krishsingh2008/haptic-teleop-arm/docs/images/glove-v2-concept.png

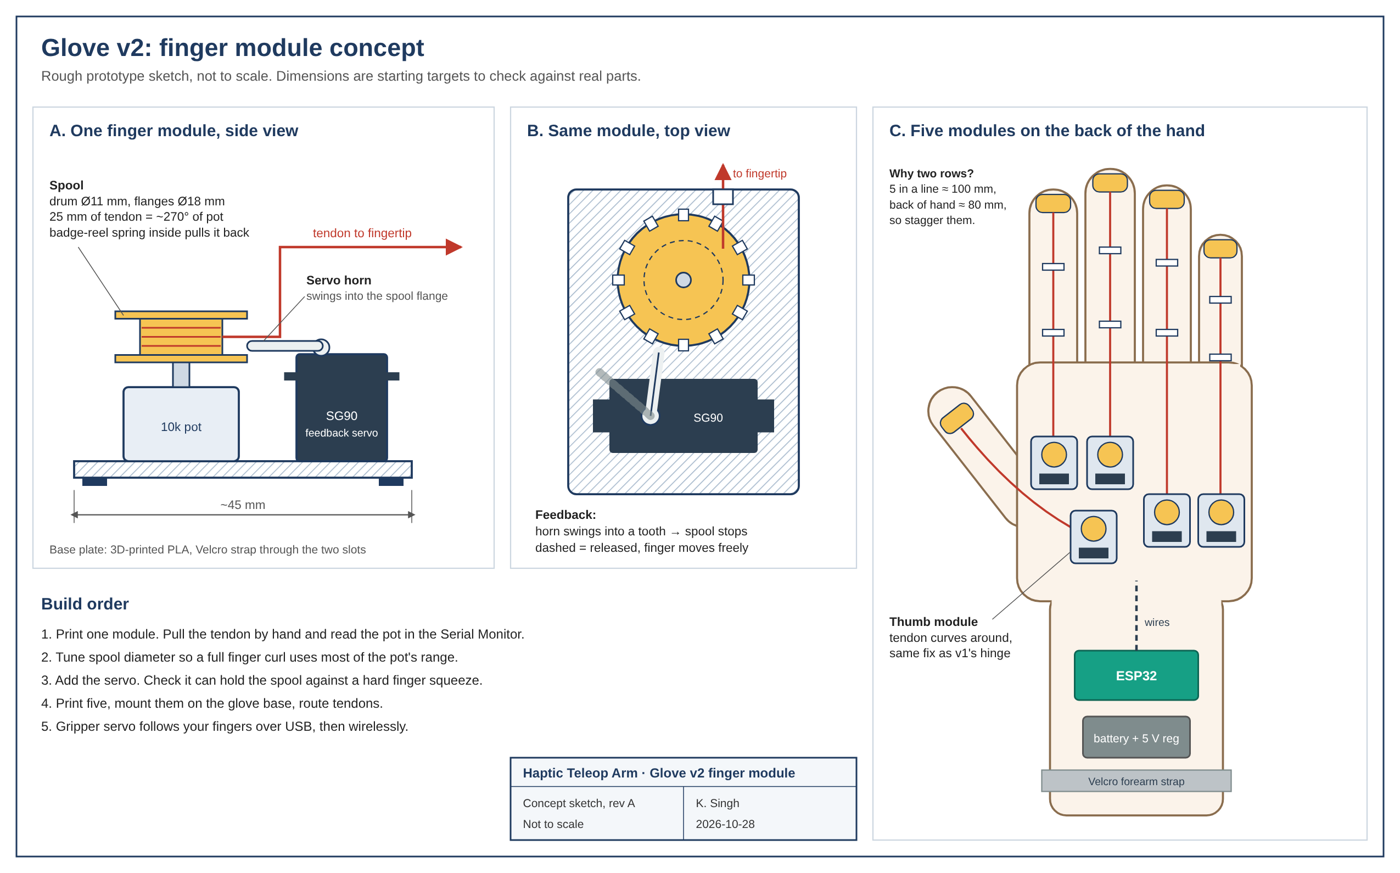
docs/images/glove-v2-concept.png
