krishsingh2008/haptic-teleop-arm/cad/hand_assembly.step

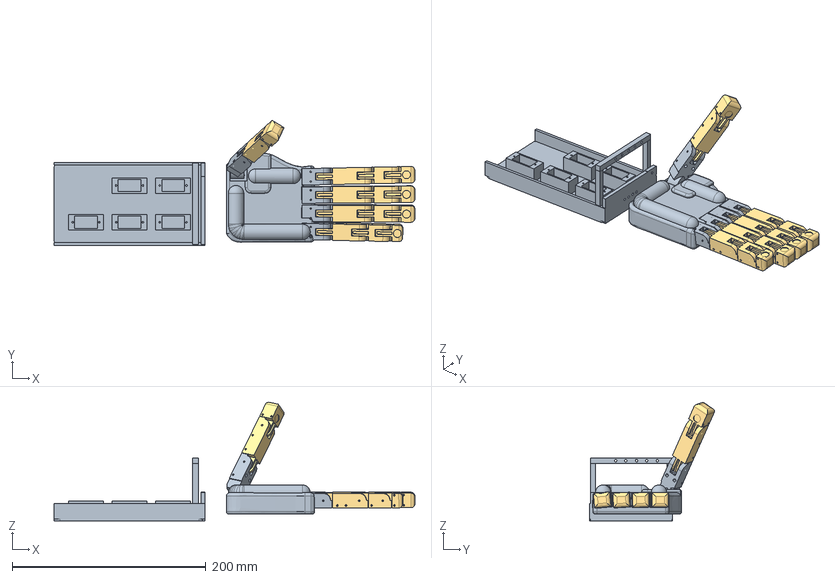
[picture p5: CAD file, 2026-11-10]
cad/hand_assembly.step
372.8 x 129.2 x 122.4 mm
palm
base_0
finger_proximal_0
finger_middle_0
finger_distal_0
base_1
finger_proximal_1
finger_middle_1
finger_distal_1
base_2
finger_proximal_2
finger_middle_2
finger_distal_2
base_3
little_proximal_3
little_middle_3
little_distal_3
thumb_carrier
thumb_proximal
thumb_distal
forearm_tray
s6_cover
tendon_comb
