krishsingh2008/haptic-teleop-arm/cad/parts/tendon_comb.step

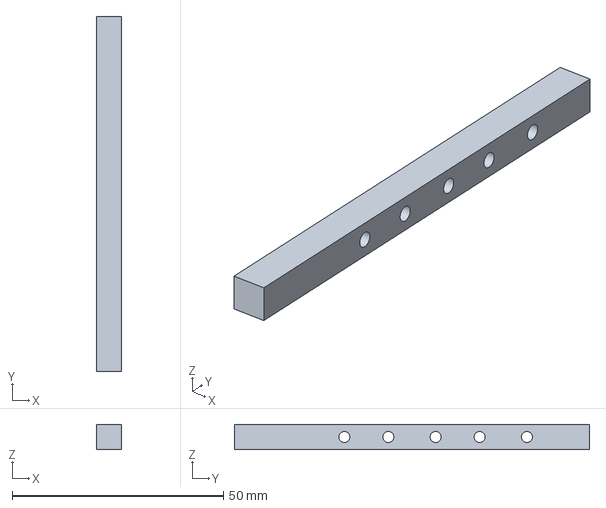
[picture p6: CAD file, 2026-11-10]
cad/parts/tendon_comb.step
6.00 x 84.0 x 6.00 mm
