krishsingh2008/haptic-teleop-arm/cad/parts_revC/finger_proximal.step

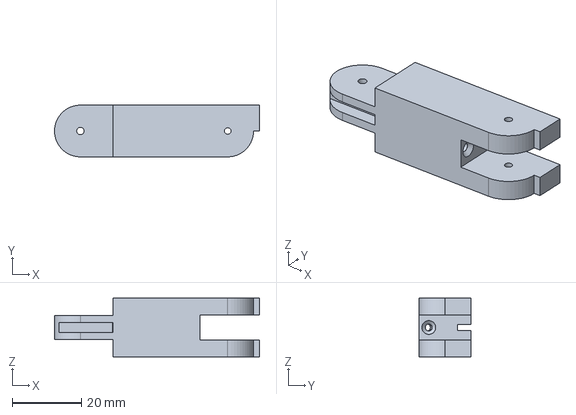
[picture p7: CAD file, 2026-11-10]
cad/parts_revC/finger_proximal.step
59.4 x 15.0 x 17.0 mm
