krishsingh2008/haptic-teleop-arm/cad/parts_revC/finger_middle.step

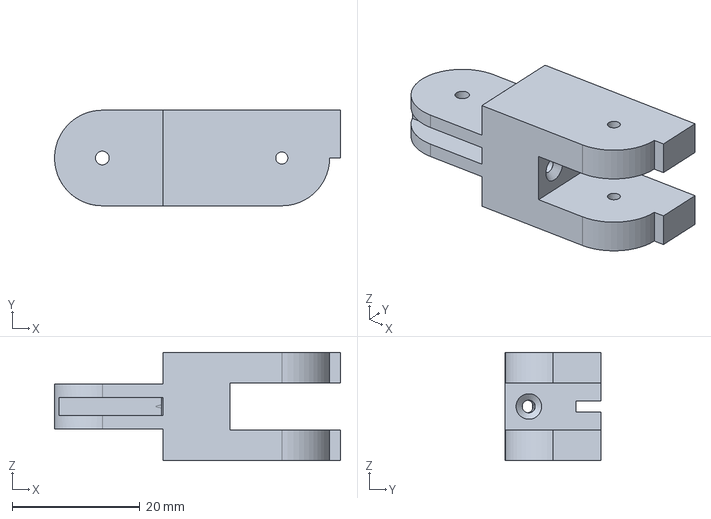
[picture p8: CAD file, 2026-11-10]
cad/parts_revC/finger_middle.step
44.8 x 15.0 x 17.0 mm
