krishsingh2008/haptic-teleop-arm/cad/parts/little_distal.step

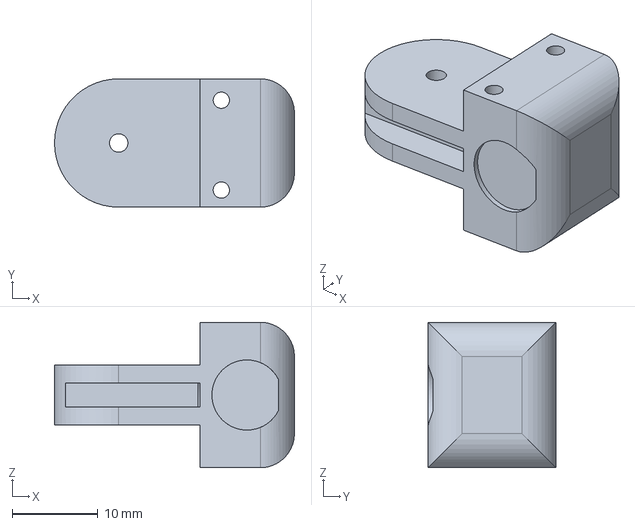
[picture p9: CAD file, 2026-11-10]
cad/parts/little_distal.step
28.1 x 15.0 x 17.0 mm
