krishsingh2008/haptic-teleop-arm/cad/parts/spool_20.step

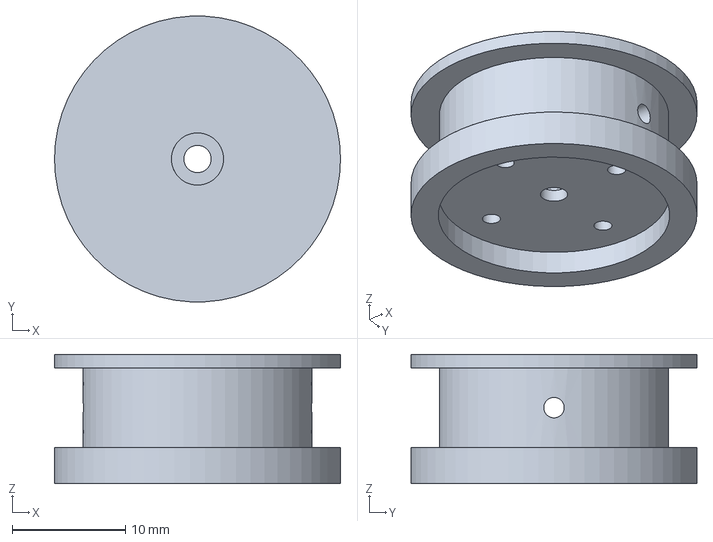
[picture p11: CAD file, 2026-11-10]
cad/parts/spool_20.step
25.2 x 25.2 x 11.4 mm
