krishsingh2008/haptic-teleop-arm/cad/parts_revC/finger_distal.step

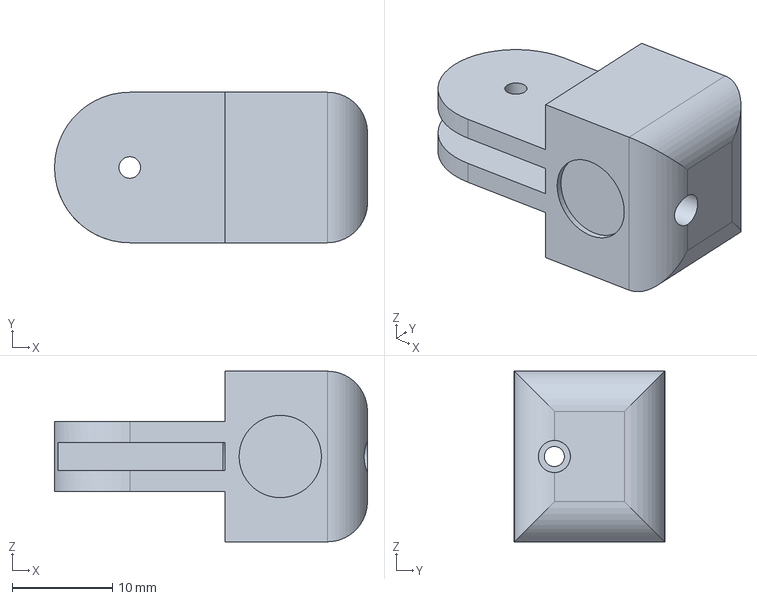
[picture p12: CAD file, 2026-11-10]
cad/parts_revC/finger_distal.step
31.2 x 15.0 x 17.0 mm
