krishsingh2008/haptic-teleop-arm/cad/parts/little_middle.step

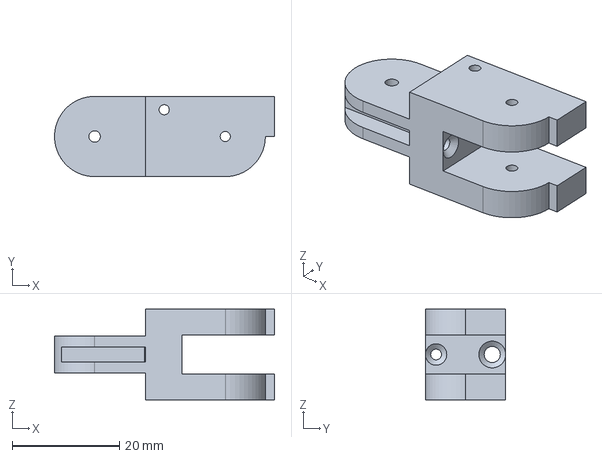
[picture p13: CAD file, 2026-11-10]
cad/parts/little_middle.step
41.1 x 15.0 x 17.0 mm
