krishsingh2008/haptic-teleop-arm/cad/parts/little_proximal.step

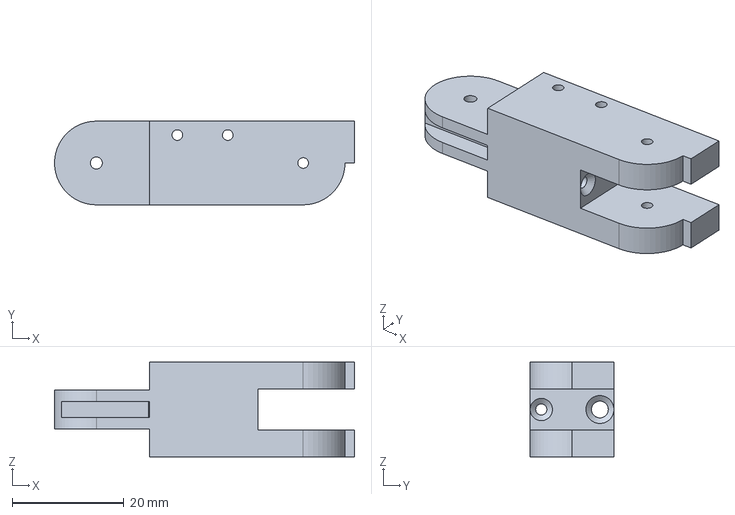
[picture p14: CAD file, 2026-11-10]
cad/parts/little_proximal.step
53.7 x 15.0 x 17.0 mm
