krishsingh2008/haptic-teleop-arm/cad/parts/s6_cover.step

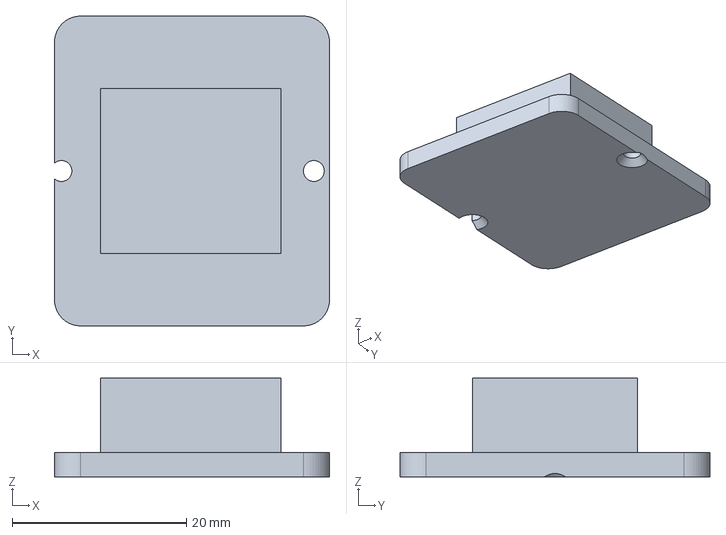
[picture p15: CAD file, 2026-11-10]
cad/parts/s6_cover.step
31.6 x 35.6 x 11.4 mm
