krishsingh2008/haptic-teleop-arm/cad/parts/forearm_tray.step

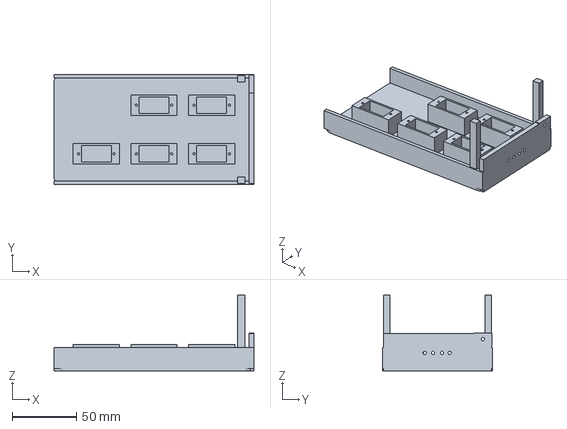
[picture p16: CAD file, 2026-11-10]
cad/parts/forearm_tray.step
156.0 x 86.0 x 59.0 mm
