krishsingh2008/haptic-teleop-arm/cad/parts/thumb_carrier.step

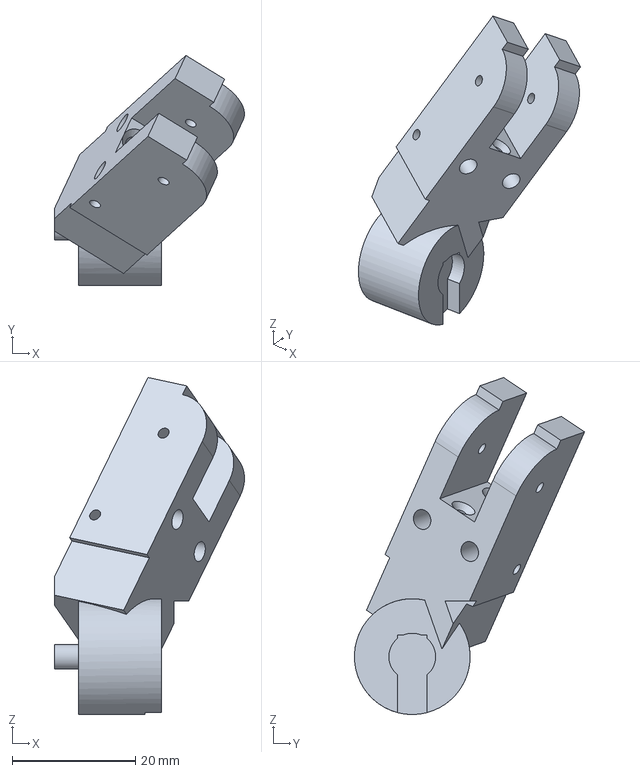
[picture p17: CAD file, 2026-11-10]
cad/parts/thumb_carrier.step
30.9 x 37.4 x 54.7 mm
