krishsingh2008/haptic-teleop-arm/cad/parts/palm.step

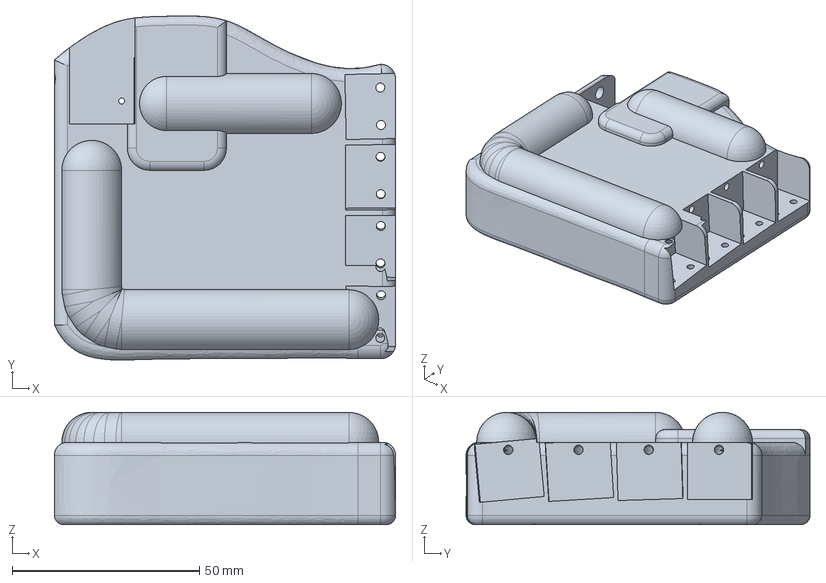
[picture p18: CAD file, 2026-11-10]
cad/parts/palm.step
91.2 x 92.0 x 30.0 mm
