krishsingh2008/haptic-teleop-arm/cad/parts/spool_32.step

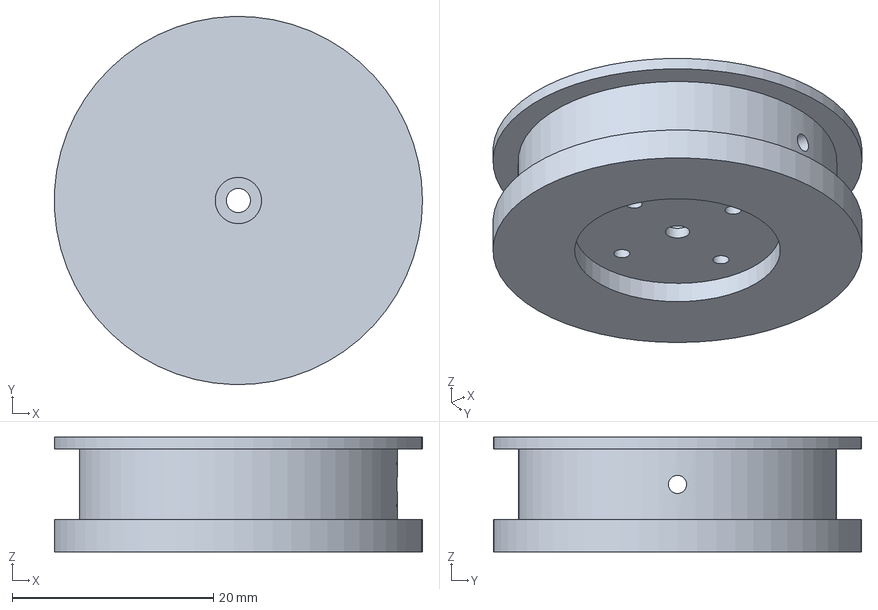
[picture p20: CAD file, 2026-11-10]
cad/parts/spool_32.step
36.6 x 36.6 x 11.4 mm
