krishsingh2008/haptic-teleop-arm/cad/parts/finger_test_rig.step

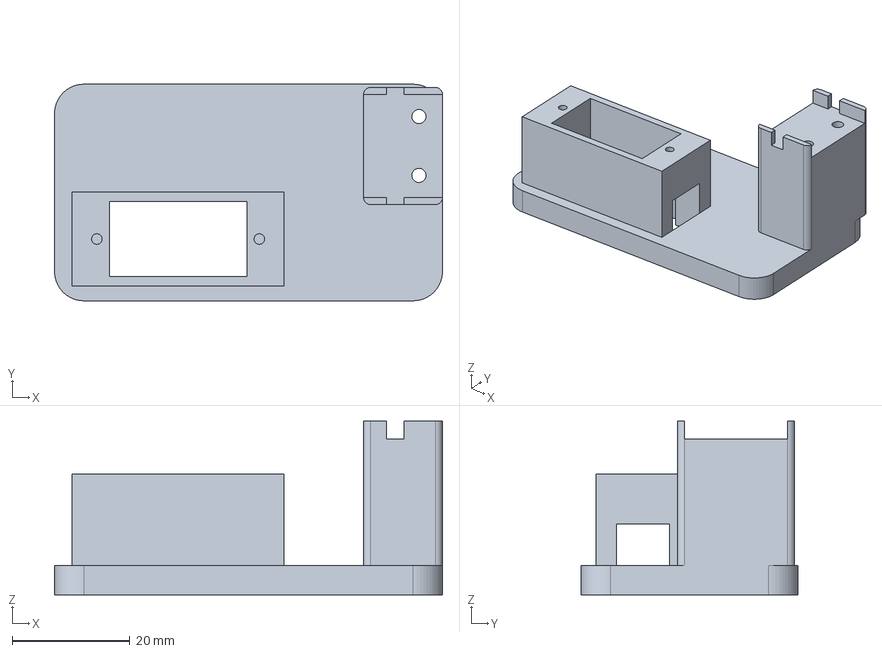
[picture p21: CAD file, 2026-11-10]
cad/parts/finger_test_rig.step
65.9 x 36.8 x 29.5 mm
