krishsingh2008/haptic-teleop-arm/cad/parts/thumb_proximal.step

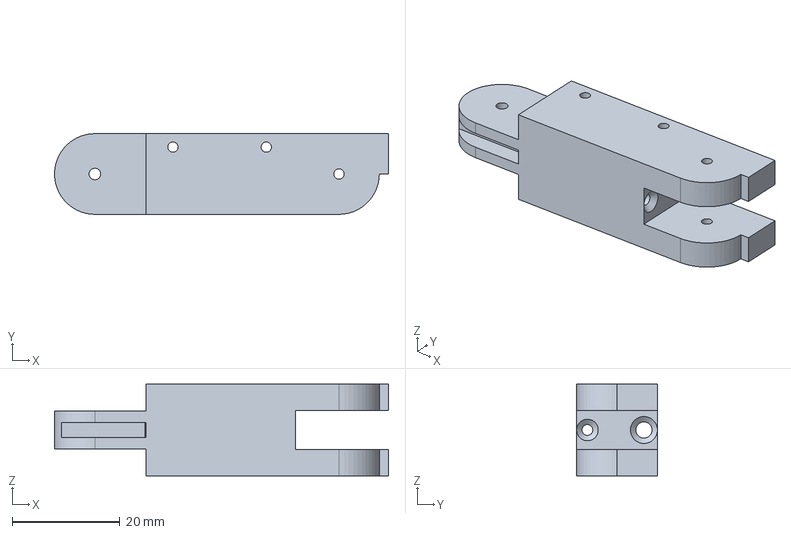
[picture p22: CAD file, 2026-11-10]
cad/parts/thumb_proximal.step
62.0 x 15.0 x 17.0 mm
