krishsingh2008/haptic-teleop-arm/cad/parts/finger_base.step

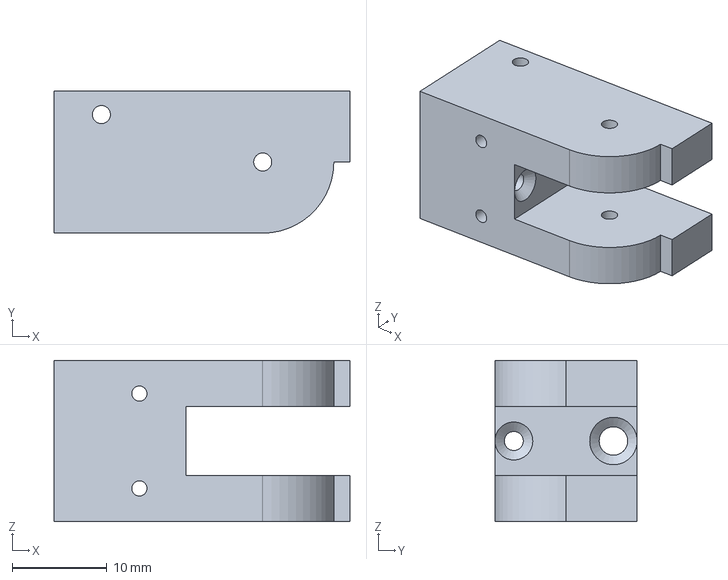
[picture p23: CAD file, 2026-11-10]
cad/parts/finger_base.step
31.2 x 15.0 x 17.0 mm
