krishsingh2008/haptic-teleop-arm/cad/parts/thumb_distal.step

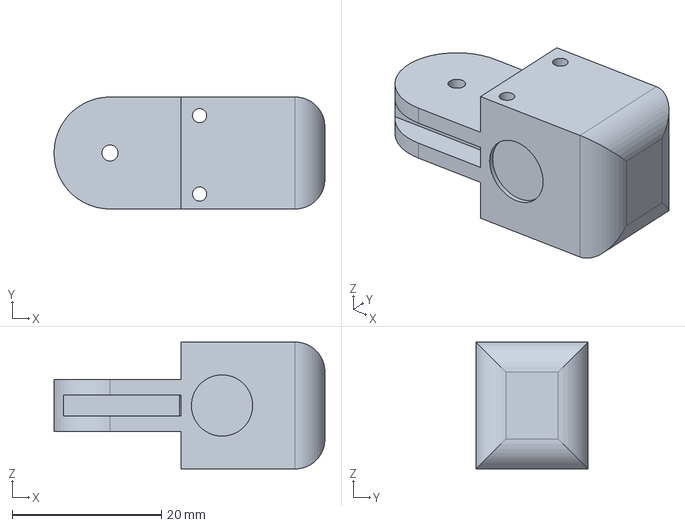
[picture p24: CAD file, 2026-11-10]
cad/parts/thumb_distal.step
36.3 x 15.0 x 17.0 mm
