krishsingh2008/haptic-teleop-arm/(list of files, cad)

Other CAD files:
cad/parts/finger_proximal.step
cad/parts/finger_middle.step
cad/parts/finger_base.stl
cad/parts/finger_distal.stl
cad/parts/finger_middle.stl
cad/parts/finger_proximal.stl
cad/parts/finger_test_rig.stl
cad/parts/forearm_tray.stl
cad/parts/little_distal.stl
cad/parts/little_middle.stl
cad/parts/little_proximal.stl
cad/parts/palm.stl
cad/parts/rig_washer.stl
cad/parts/s6_cover.stl
cad/parts/spool_20.stl
cad/parts/spool_32.stl
cad/parts/tendon_comb.stl
cad/parts/thumb_carrier.stl
cad/parts/thumb_distal.stl
cad/parts/thumb_proximal.stl
cad/parts_revC/finger_base.stl
cad/parts_revC/finger_distal.stl
cad/parts_revC/finger_middle.stl
cad/parts_revC/finger_proximal.stl
